j3qq4hch/motion_detect/V4/motion-sensor.png

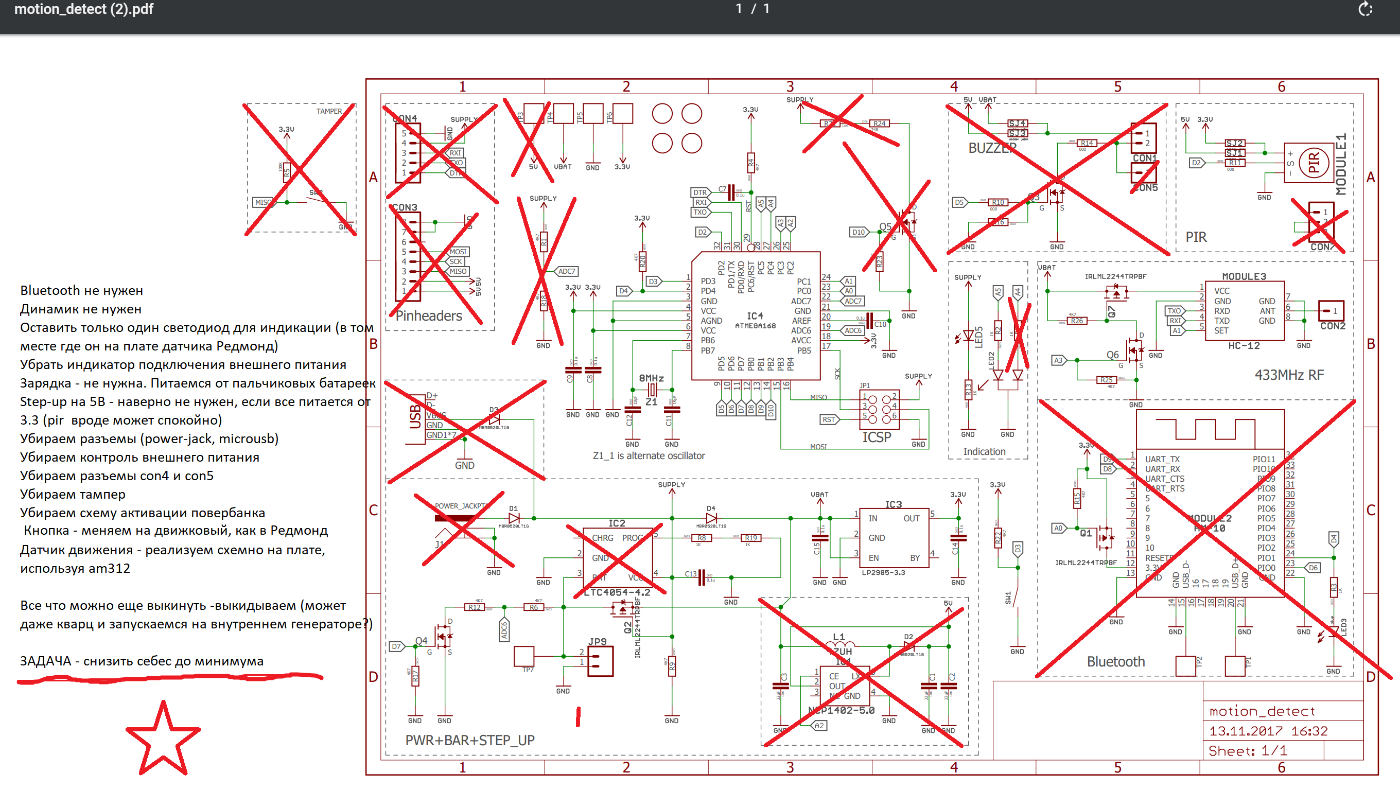
V4/motion-sensor.png
