j3qq4hch/motion_detect/V4/production/BOM.xlsx

Qty | Value | Device | Package | Parts | DIGIKEY# | LINK | MANF | MANF# | Description
1 | RED | LED-3MM | LED-3MM | LED1 |  | https://www.chipdip.ru/product/l-1154id |  |  | Light Emitting Diode
1 |  | M03X2POGO_PINS | 2X3_POGO | JP1 |  | https://www.chipdip.ru/product/pbd-6 |  |  | 2x3 .1 header."
2 | 0.1u | C-0603 | C0603 | C7, C10 |  | https://www.chipdip.ru/product0/9000410929
3 | 0 | R-0603 | R0603 | R8, R9, R10 |  | https://www.chipdip.ru/product0/9000070541
2 | 32pF | C-0603 | C0603 | C11, C12 |  | https://www.chipdip.ru/product/grm1885c1h300j
3 | 1K | R-0603 | R0603 | R13, R20, R27 |  | https://www.chipdip.ru/product0/9000079676
2 | 1M | R-0603 | R0603 | R2, R3 |  | https://www.chipdip.ru/product0/9000079784
7 | 1uF | C-0603 | C0603 | C1, C2, C3, C8, C9, C14, C15 |  | https://www.chipdip.ru/product/grm188r61a105k
1 |  | LP2985-3.3V | SOT23-5L | IC3 | 296-18476-1-ND | https://www.chipdip.ru/product/lp2985-33dbvr | Texas Instruments | LP2985-33DBVR | IC REG LDO 3.3V 0.15A SOT23-5
6 | 4K7 | R-0603 | R0603 | R1, R4, R18, R22, R25, R26 |  | https://www.chipdip.ru/product0/9000079728
1 | 8MHz | CRYSTAL-8MHZHC49UP | HC49UP | Z1 | 535-10212-1-ND | https://www.chipdip.ru/product/8mhz-hc-49sm | Abracon LLC | ABLS-8.000MHZ-B4-T
1 | AM612 | AM612 | AM612 | IC1
1 | ATMEGA168-TQFP32 | ATMEGA168-TQFP32 | TQFP32-08 | IC4 |  | https://www.chipdip.ru/product/atmega168pa-au |  | ATMEGA168
1 | FTDI Basic | ARDUINO_SERIAL_PROGRAMPTH | 1X06 | JP2 |  | https://www.chipdip.ru/product/pls-6
1 | HC12 | HC12 | HC-12 | MODULE3
2 | IRLML2244TRPBF | IRLML2244TRPBF | SOT23B-3 | Q1, Q7 | IRLML2244TRPBFCT-ND | https://www.chipdip.ru/product/irlml2244trpbf | Infineon Technologies | IRLML2244TRPBF | MOSFET P-CH 20V 4.3A SOT23
1 | IRLML2502-SOT23 | IRLML2502-SOT23 | SOT23B-3 | Q6 | IRLML2502PBFTR-ND | https://www.chipdip.ru/product/irlml2502tr | Infineon Technologies | IRLML2502TRPBF | MOSFET N-CH 20V 4.2A SOT-23
1 | PESD5V0S1BB,115 | PESD5V0S1BB,115 | SOD123 | D1 | 1727-3838-2-ND | https://www.chipdip.ru/product/pesd5v0s1ba.115 | Nexperia USA Inc | PESD5V0S1BB,115
1 | TACT_SWITCH-IT-1102S | TACT_SWITCH-IT-1102S | IT-1102S | SW1 |  | https://www.chipdip.ru/product/kls7-ts6604-4.3-180-b-it-1102s
3 | 330K | R-0603 | R0603 | R5, R6, R7 |  | https://www.chipdip.ru/product0/9000079772
