j3qq4hch/motion_detect/(threads)

Thread 1 (2017-06-05):

Большой зазор меду платой и планкой корпуса

Zentelechia, 2017-06-05:
Необходимо на 2мм удлинить сторону с разъемами и светодиодами, т.к, большой зазор до планки корпуса - кнопка не достает до планки, usb-разъем не полностью влезает
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
