j3qq4hch/motion_detect/V4/production/assembly.pdf

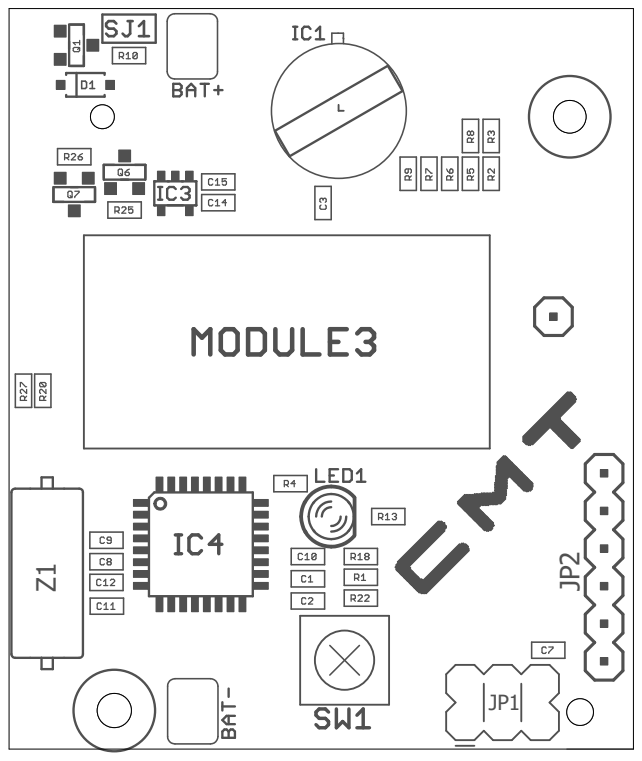
[picture p2: page 1]
