j3qq4hch/motion_detect/V1/production/schematic.pdf

1

2

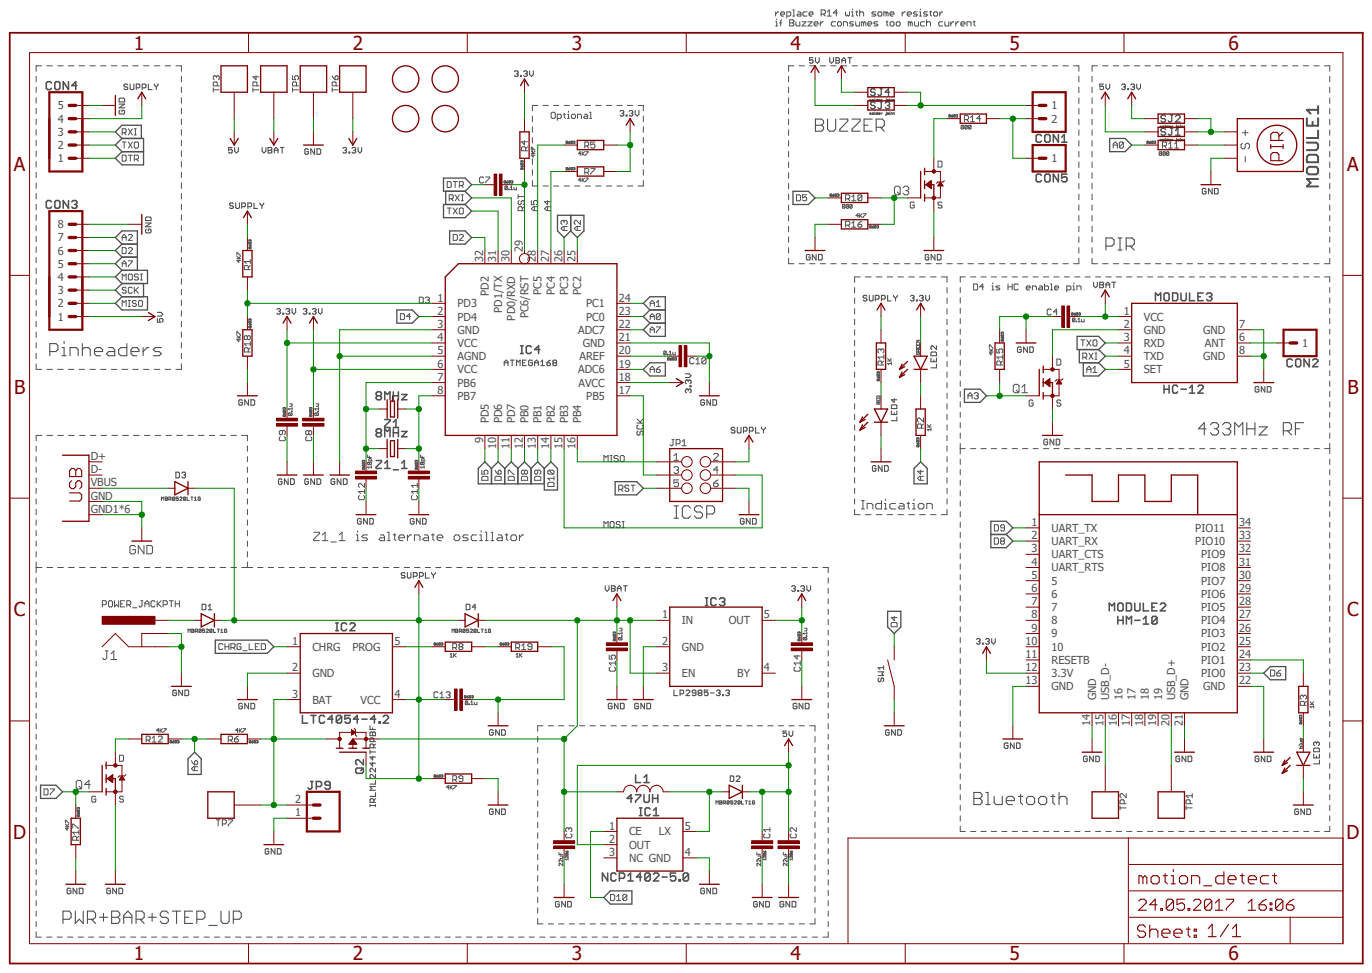
[picture p3: page 1]
OUT; GND; ADC6; ADC7; AGND; AREF; AVCC; VCC; CHRG; BAT; PROG; UART_TX; UART_RX; UART_CTS; UART_RTS; 9 10 10 RESETB 11 3.3V 12 GND 13; GND 14; USB_D- 15; USB_D+ 20 GND 21; 22 PIO0; 23 PIO1; 24 PIO2; 25 PIO3; 26 PIO4; 27 PIO5; 28 PIO6; 29 PIO7; 30 PIO8; 31 PIO9; 32 PIO10; 33 PIO11; RXD; TXD; SET; ANT; 6 GND; D+ D- VBUS GND GND1*6; ABCD

PC2 25 PC3 26 PC4 27 PC5 28 PC6/RST 29 PD0/RXD 30 PD1/TX 31 PD2 32
