j3qq4hch/motion_detect/V3.2/production/bottom.pdf

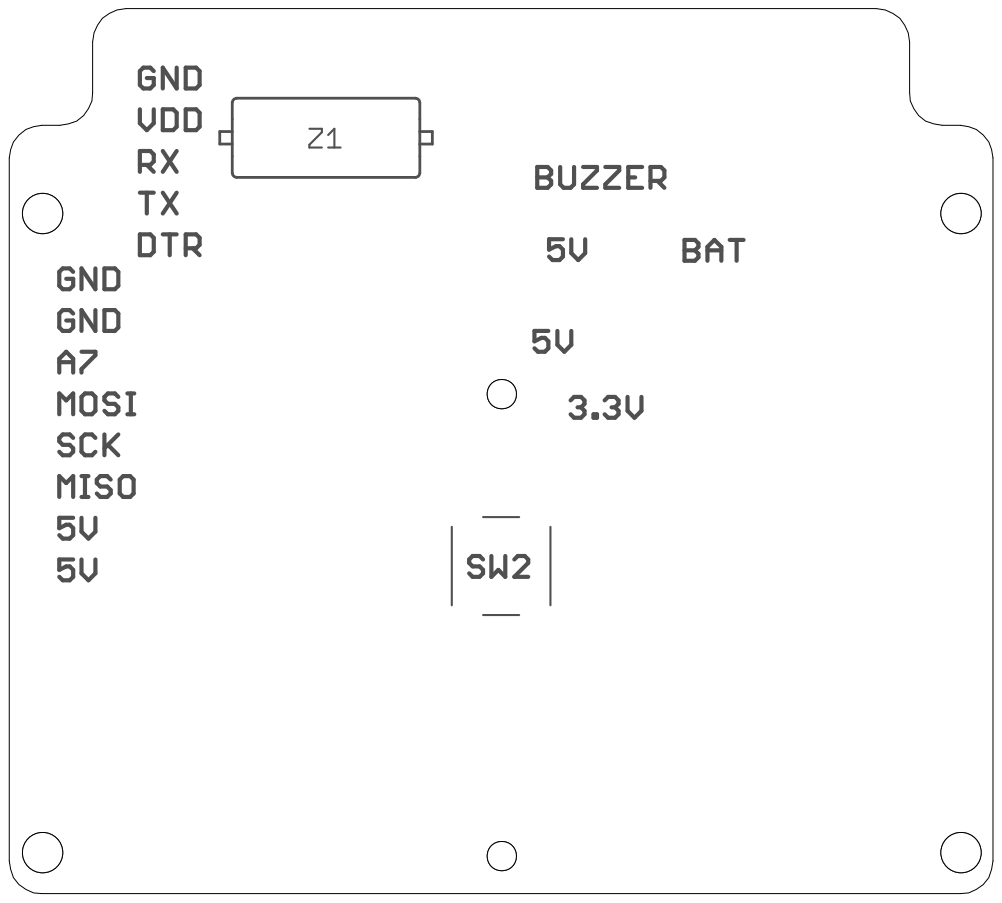
[picture p4: page 1]
