j3qq4hch/motion_detect/V3.2/production/top.pdf

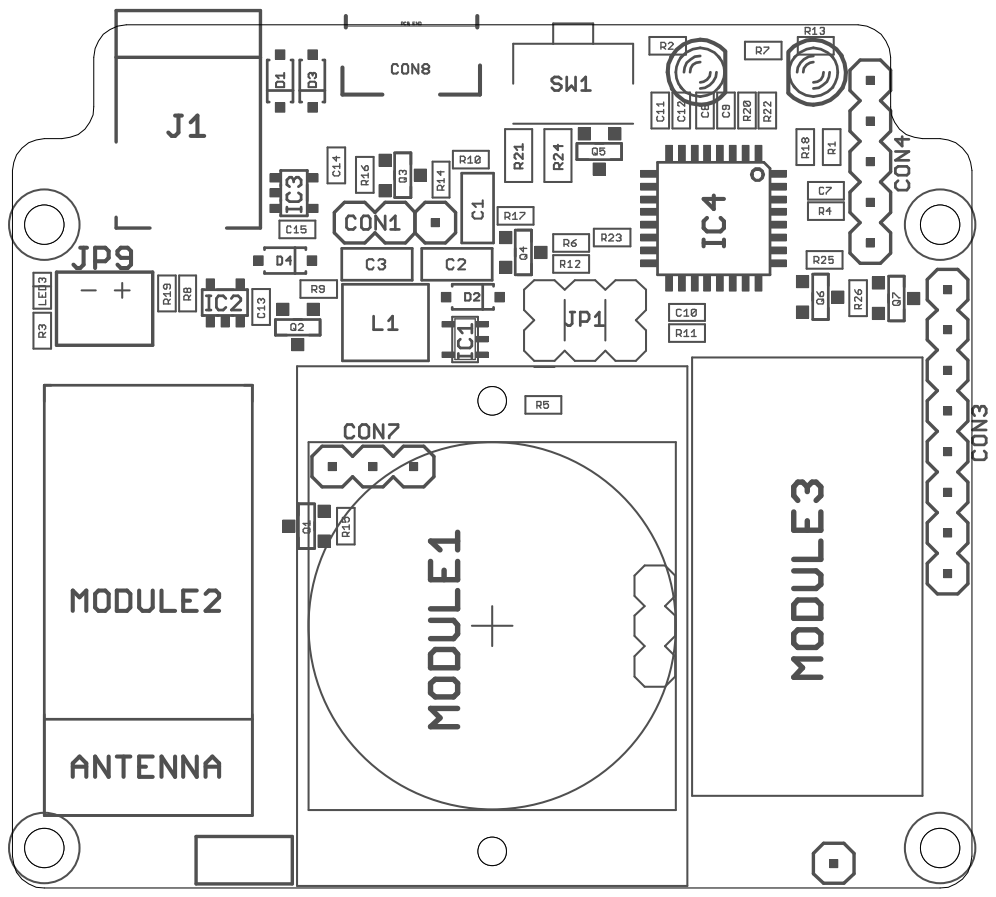
[picture p5: page 1]
