j3qq4hch/motion_detect/V1/production/assy.pdf

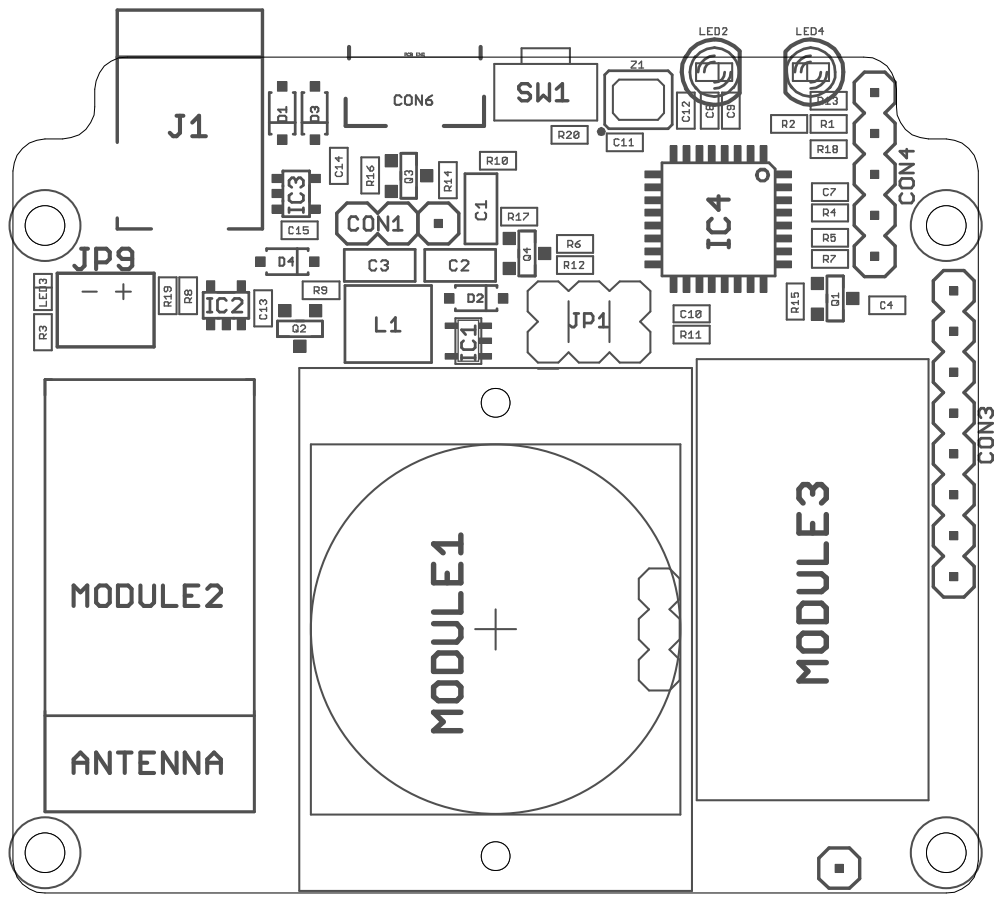
[picture p6: page 1]
