j3qq4hch/motion_detect/V4/motion_detect.brd

## EAGLE design V4/motion_detect.brd (2018-05-14)

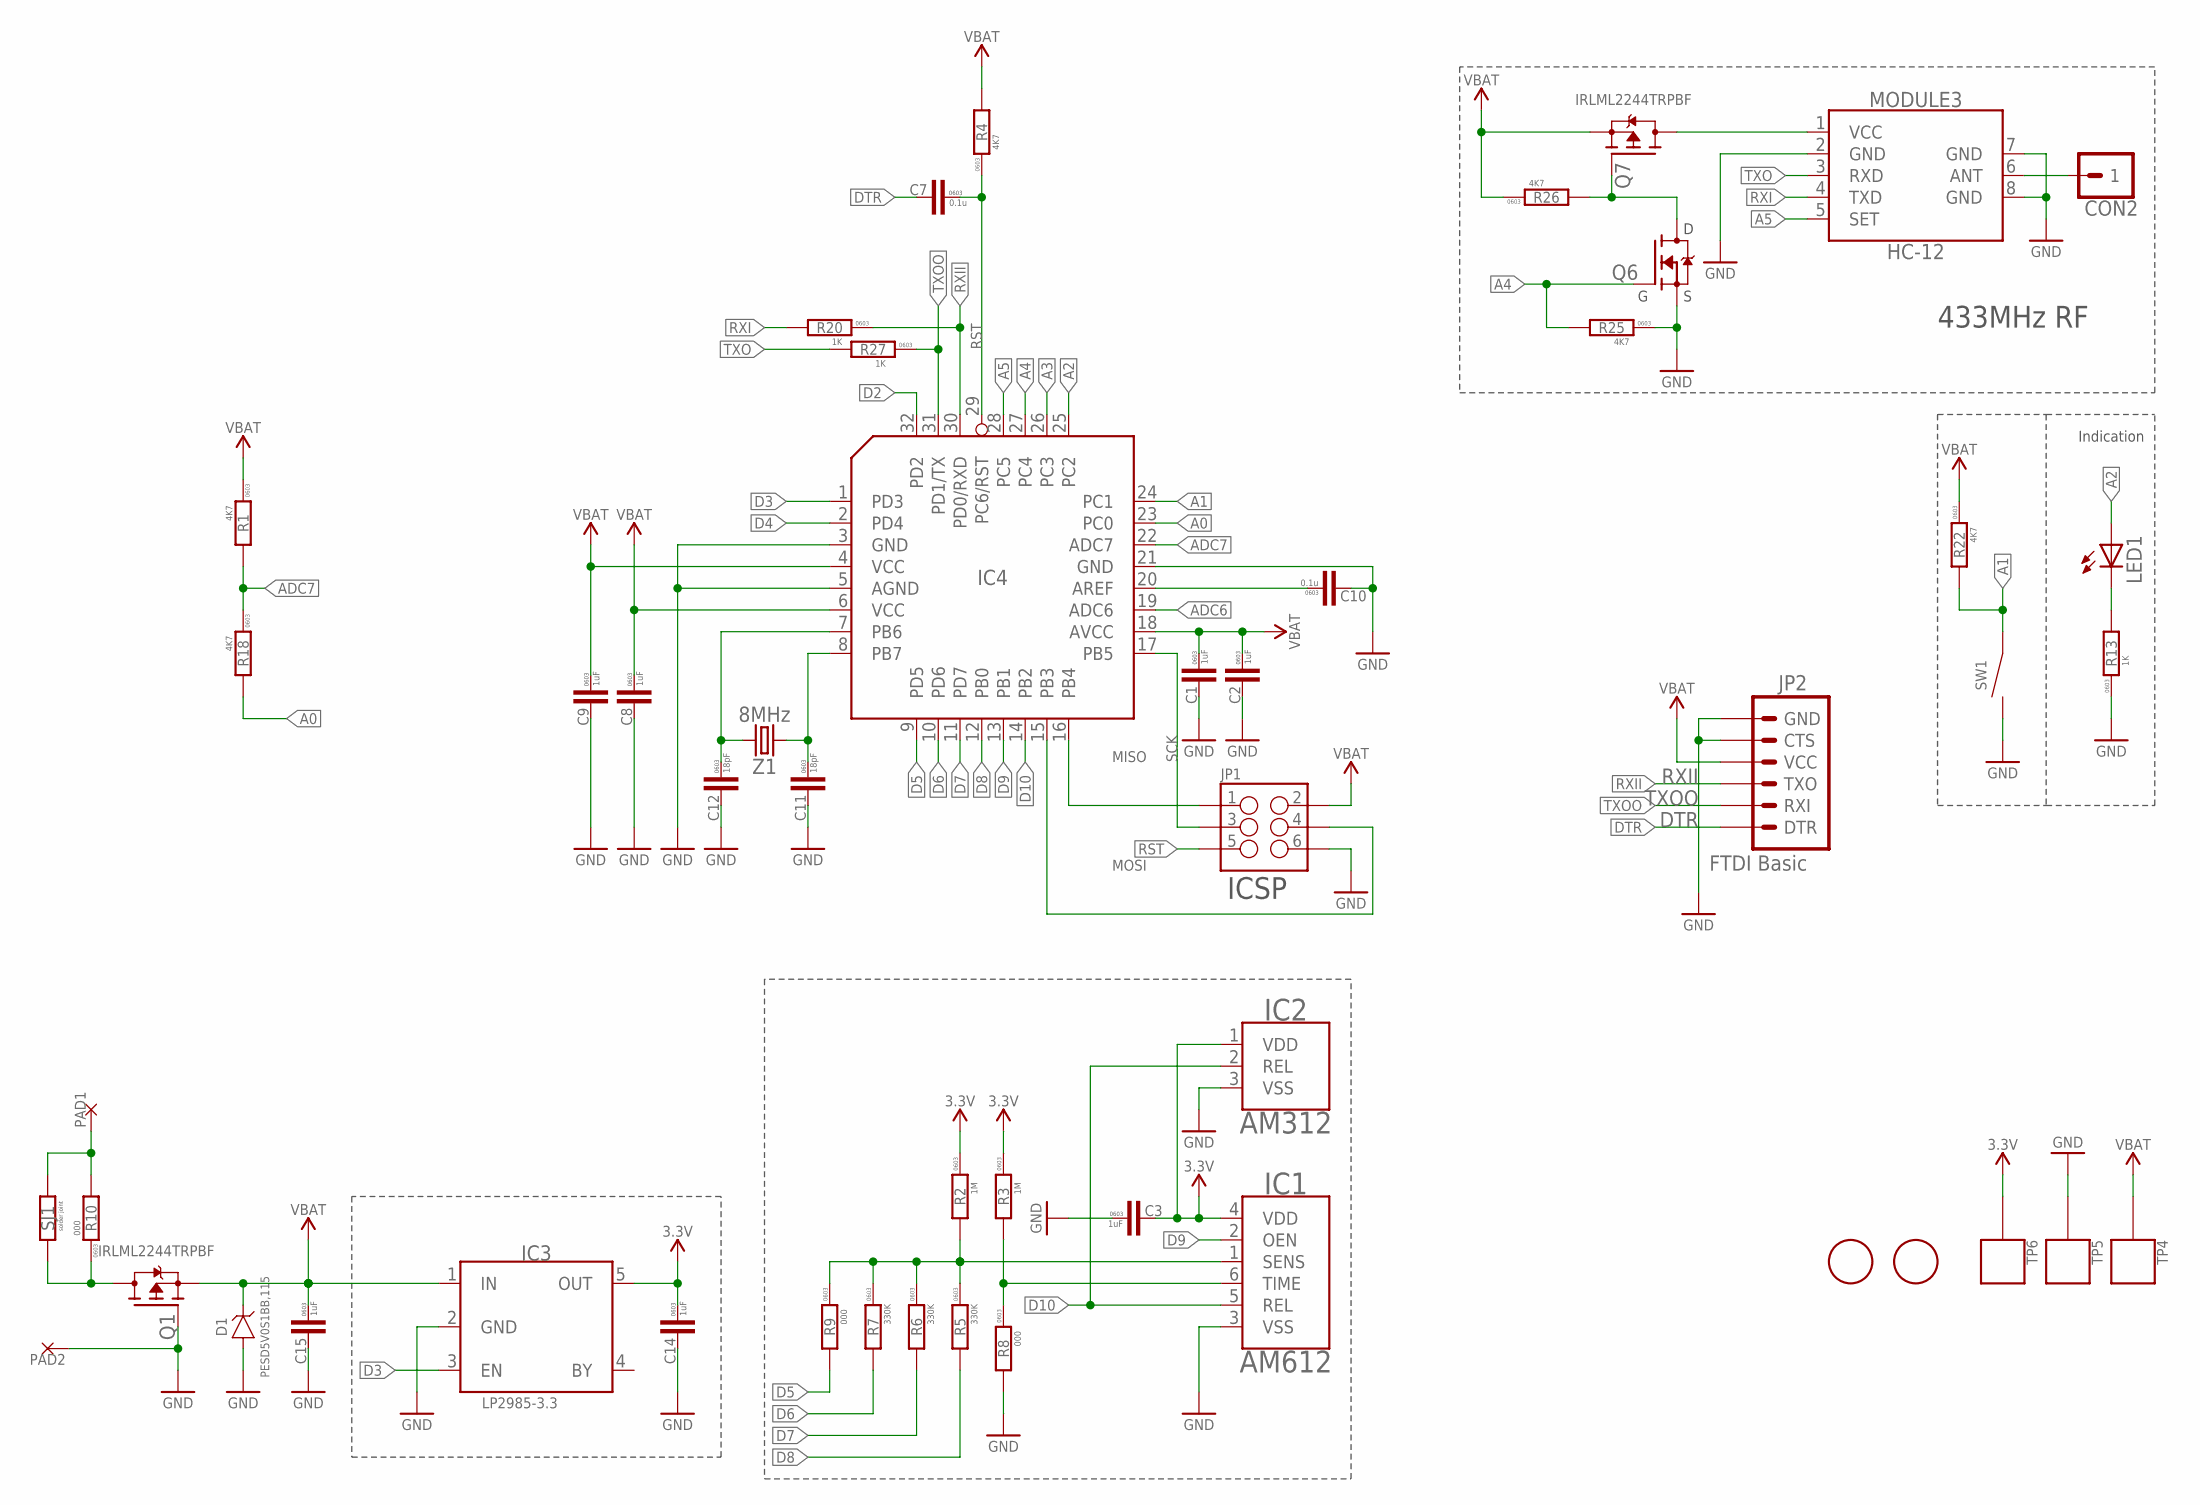
[picture p7: schematic motion_detect.sch]

Parts:
C1, C2, C3, C8, C9, C14, C15: 1uF; C0603
C7, C10: 0.1u; C0603
C11, C12: 18pF; C0603
CON2: PINHEAD_1X01-2.54; 1X01-PTH-2.54
D1: PESD5V0S1BB,115; SOD123
IC1: AM612
IC2: AM312; AM312_SIL
IC3: 3.3; SOT23-5L
IC4: ATMEGA168-TQFP32; TQFP32-08
JP1: M03X2POGO_PINS; 2X3_POGO
JP2: FTDI Basic; 1X06
LED1: LED-3MM
MODULE3: HC12; HC-12
PAD1, PAD2: PAD-4X3; 4X3
Q1, Q7: IRLML2244TRPBF; SOT23B-3
Q6: IRLML2502-SOT23; SOT23B-3
R1, R4, R18, R22, R25, R26: 4K7; R0603
R2, R3: 1M; R0603
R5, R6, R7: 330K; R0603
R8, R9, R10: 000; R0603
R13, R20, R27: 1K; R0603
SJ1: SOLDER_JOINT_2P; SJ_2P
SW1: TACT_SWITCH-IT-1102S; IT-1102S
TP4, TP5, TP6: PAD.05; PAD.05X.05; PARTNO *
U$4, U$6: FIDUCIALMOUNT; FIDUCIA-MOUNT
Z1: 8MHz; HC49UP

Connections:
A0: IC4.23 (PC0), R18.2
A1: IC4.24 (PC1), R22.2, SW1.1, SW1.2 (1)
A2: IC4.25 (PC2), LED1.A
A3: IC4.26 (PC3)
A4: IC4.27 (PC4), Q6.1 (G), R25.2
A5: IC4.28 (PC5), MODULE3.5 (SET)
ADC6: IC4.19 (ADC6)
ADC7: IC4.22 (ADC7), R1.2, R18.1
ANT: CON2.1, MODULE3.6 (ANT)
D2: IC4.32 (PD2)
D3: IC3.3 (EN), IC4.1 (PD3)
D4: IC4.2 (PD4)
D5: IC4.9 (PD5), R9.2
D6: IC4.10 (PD6), R7.2
D7: IC4.11 (PD7), R6.2
D8: IC4.12 (PB0), R5.2
D9: IC1.2 (OEN), IC4.13 (PB1)
D10: IC1.5 (REL), IC2.2 (REL), IC4.14 (PB2)
DTR: C7.2, JP2.1 (DTR)
GND: C1.2, C2.2, C3.1, C8.2, C9.2, C10.2, C11.2, C12.2, C14.2, C15.2, D1.A, IC1.3 (VSS), IC2.3 (VSS), IC3.2 (GND), IC4.3 (GND), IC4.5 (AGND), IC4.21 (GND), JP1.P$6 (6), JP2.5 (CTS), JP2.6 (GND), MODULE3.2 (GND), MODULE3.7 (GND), MODULE3.8 (GND), PAD2.P$1, Q1.1 (G), Q6.2 (S), R8.2, R13.1, R25.1, SW1.3 (2), SW1.4 (2), TP5.P$1
MISO: IC4.16 (PB4), JP1.P$1 (1)
MOSI: IC4.15 (PB3), JP1.P$4 (4)
unnamed: PAD1.P$1, R10.2, SJ1.2
unnamed: IC1.6 (TIME), R3.2, R8.1
unnamed: C10.1, IC4.20 (AREF)
unnamed: IC1.1 (SENS), R2.2, R5.1, R6.1, R7.1, R9.1
unnamed: C12.1, IC4.7 (PB6), Z1.2
unnamed: Q1.3 (D), R10.1, SJ1.1
unnamed: C11.1, IC4.8 (PB7), Z1.1
unnamed: LED1.K (C), R13.2
unnamed: MODULE3.1 (VCC), Q7.3 (D)
unnamed: Q6.3 (D), Q7.1 (G), R26.2
RST: C7.1, IC4.29 (PC6/RST), JP1.P$5 (5), R4.1
RXI: MODULE3.4 (TXD), R20.2
RXII: IC4.30 (PD0/RXD), JP2.3 (TXO), R20.1
SCK: IC4.17 (PB5), JP1.P$3 (3)
TXO: MODULE3.3 (RXD), R27.2
TXOO: IC4.31 (PD1/TX), JP2.2 (RXI), R27.1
VBAT: C1.1, C2.1, C8.1, C9.1, C15.1, D1.C, IC3.1 (IN), IC4.4 (VCC), IC4.6 (VCC), IC4.18 (AVCC), JP1.P$2 (2), JP2.4 (VCC), Q1.2 (S), Q7.2 (S), R1.1, R4.2, R22.1, R26.1, TP4.P$1
VDD_3V3: C3.2, C14.1, IC1.4 (VDD), IC2.1 (VDD), IC3.5 (OUT), R2.1, R3.1, TP6.P$1

Notes on the sheet:
433MHz RF
Indication
ICSP

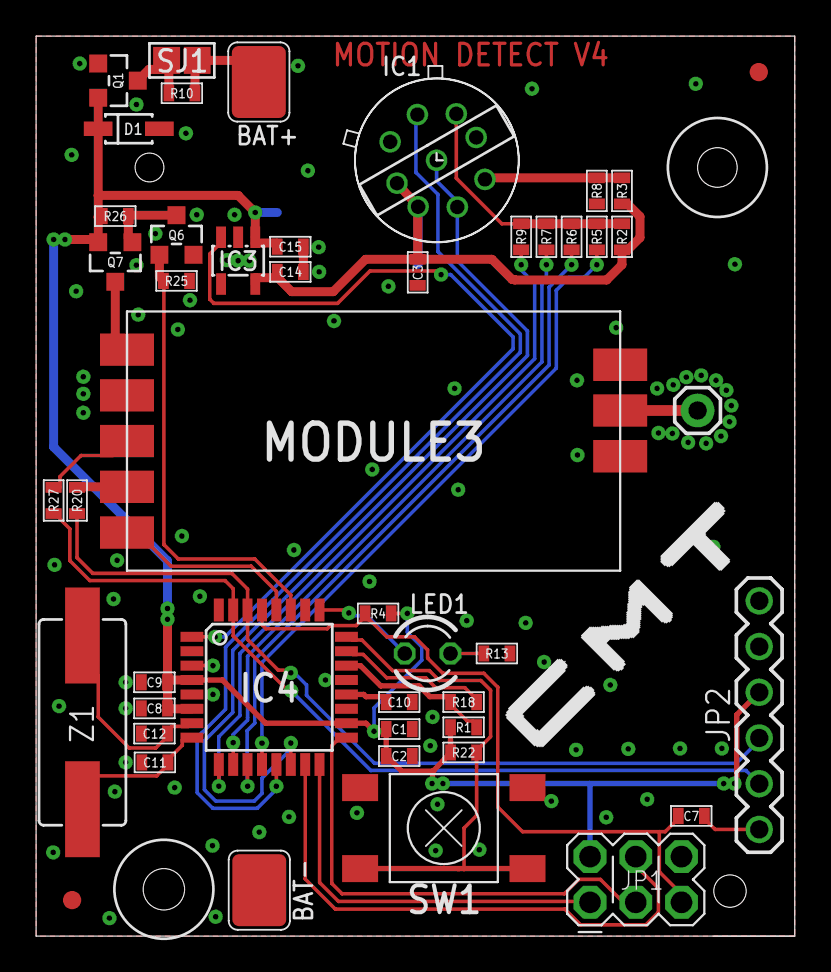
[picture p8: board V4/motion_detect.brd from above]

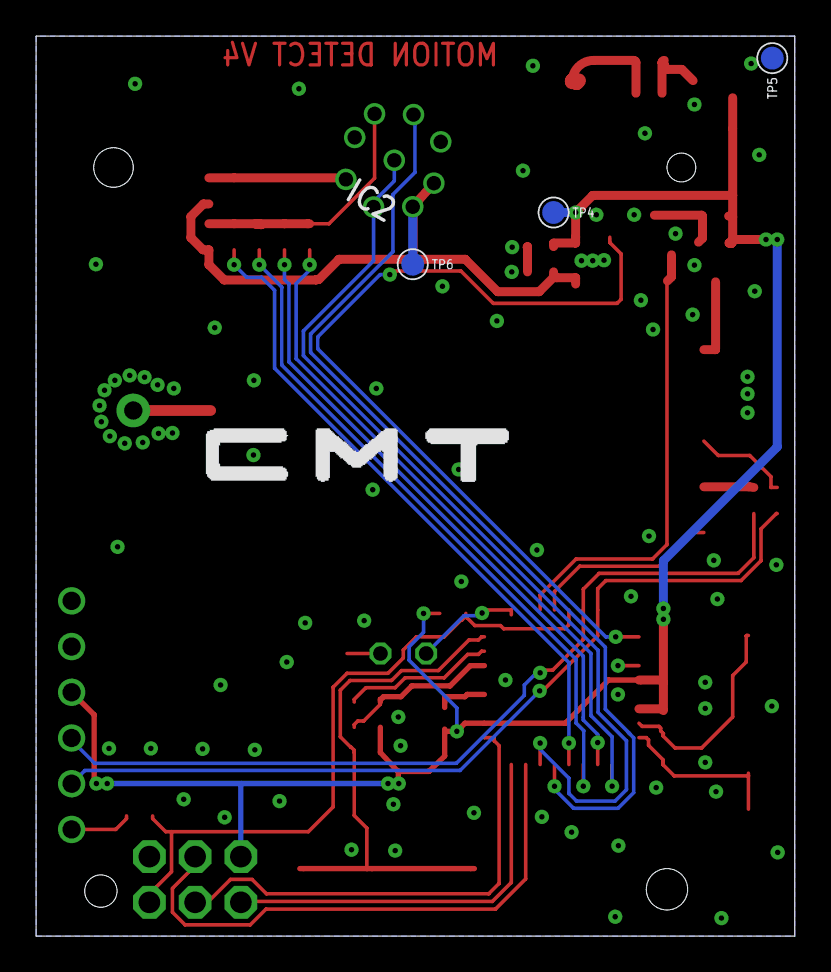
[picture p9: board V4/motion_detect.brd from below]

Board: 4 copper layers, 42.1 x 50.0 mm, 54 parts (6 on the bottom side), 36 nets.

Other parts of the board:
U$1, U$3: SMT_LOGO
U$2: REDMOND_BOARD
