j3qq4hch/motion_detect/V3.2/motion_detect.brd

## EAGLE design V3.2/motion_detect.brd (2018-05-07, an earlier design)

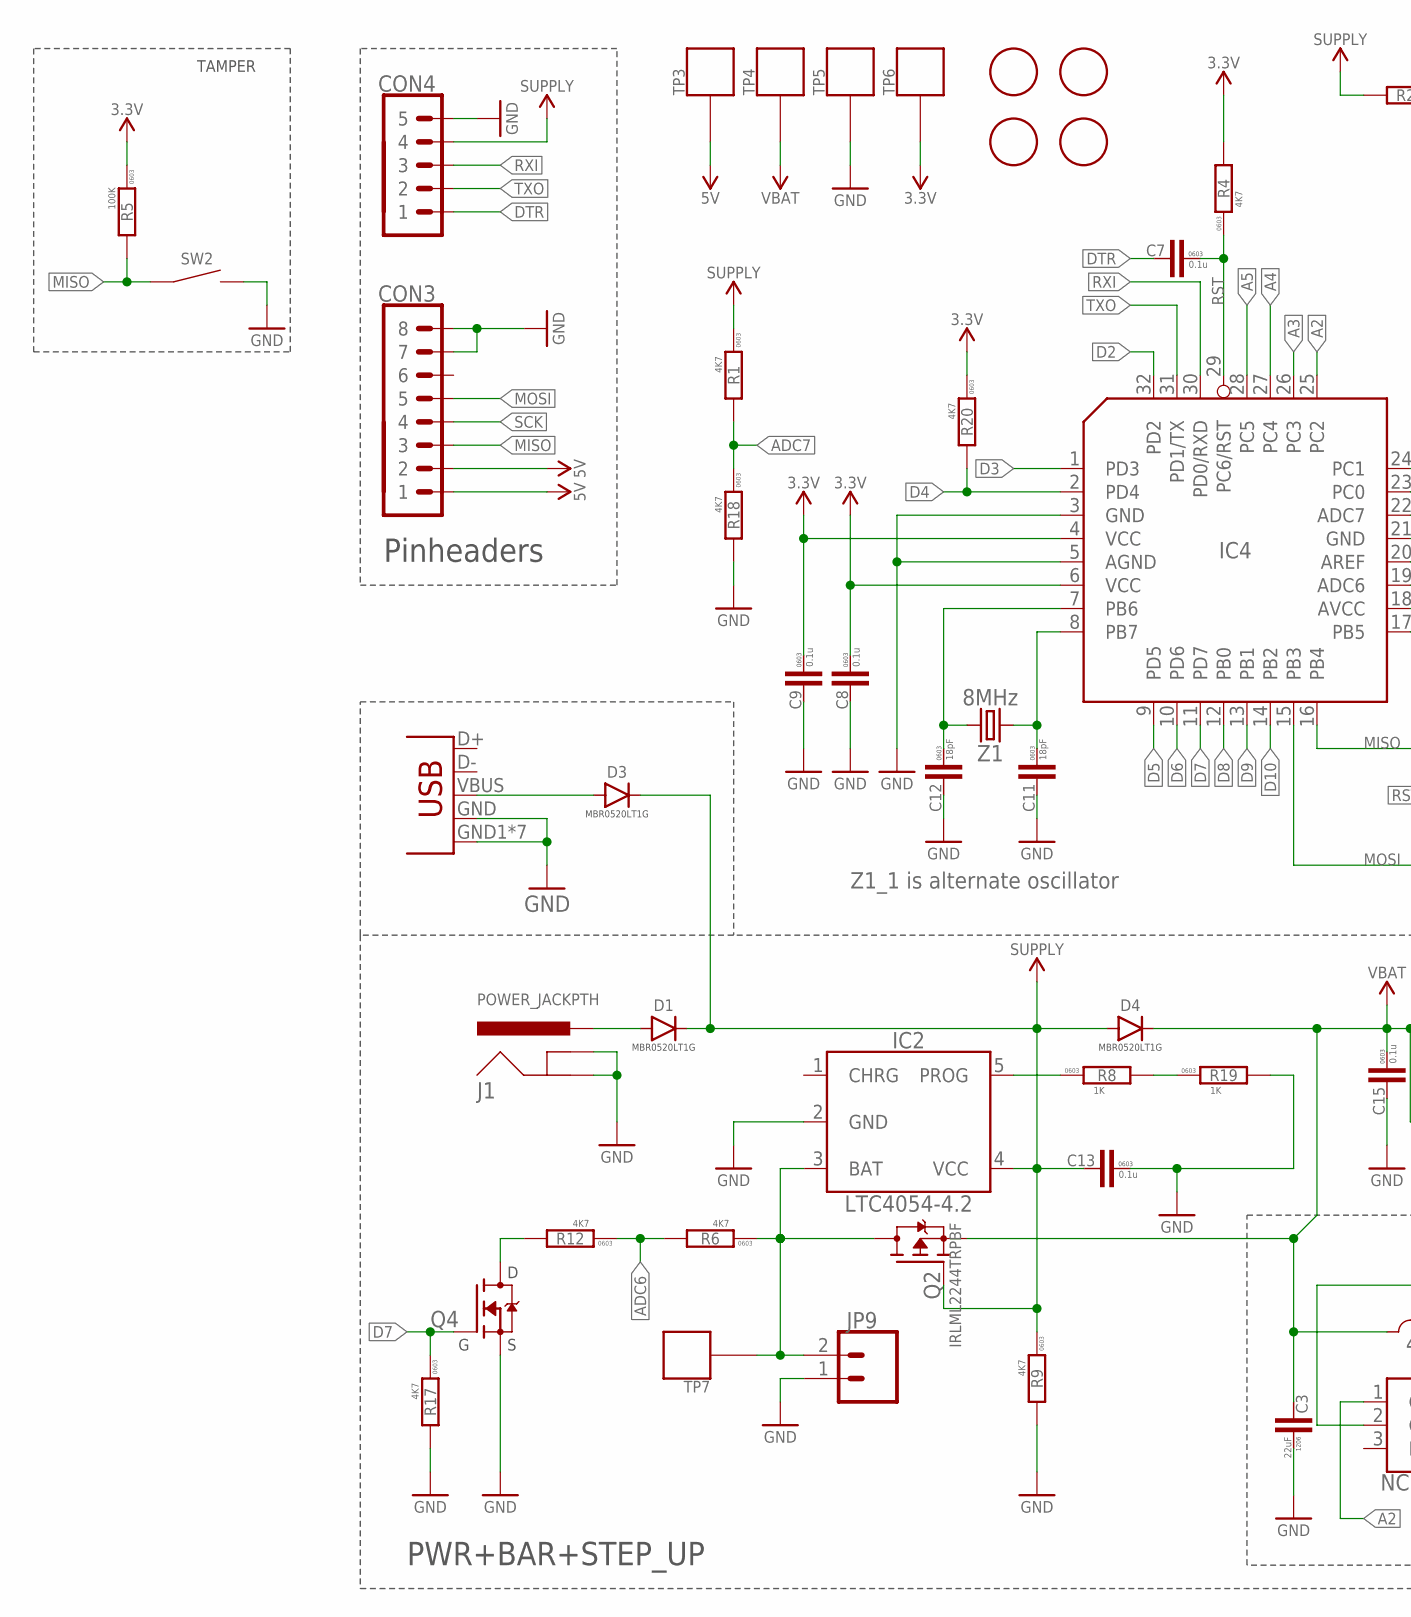
[picture p10: schematic motion_detect.sch, part in row 1, column 1]

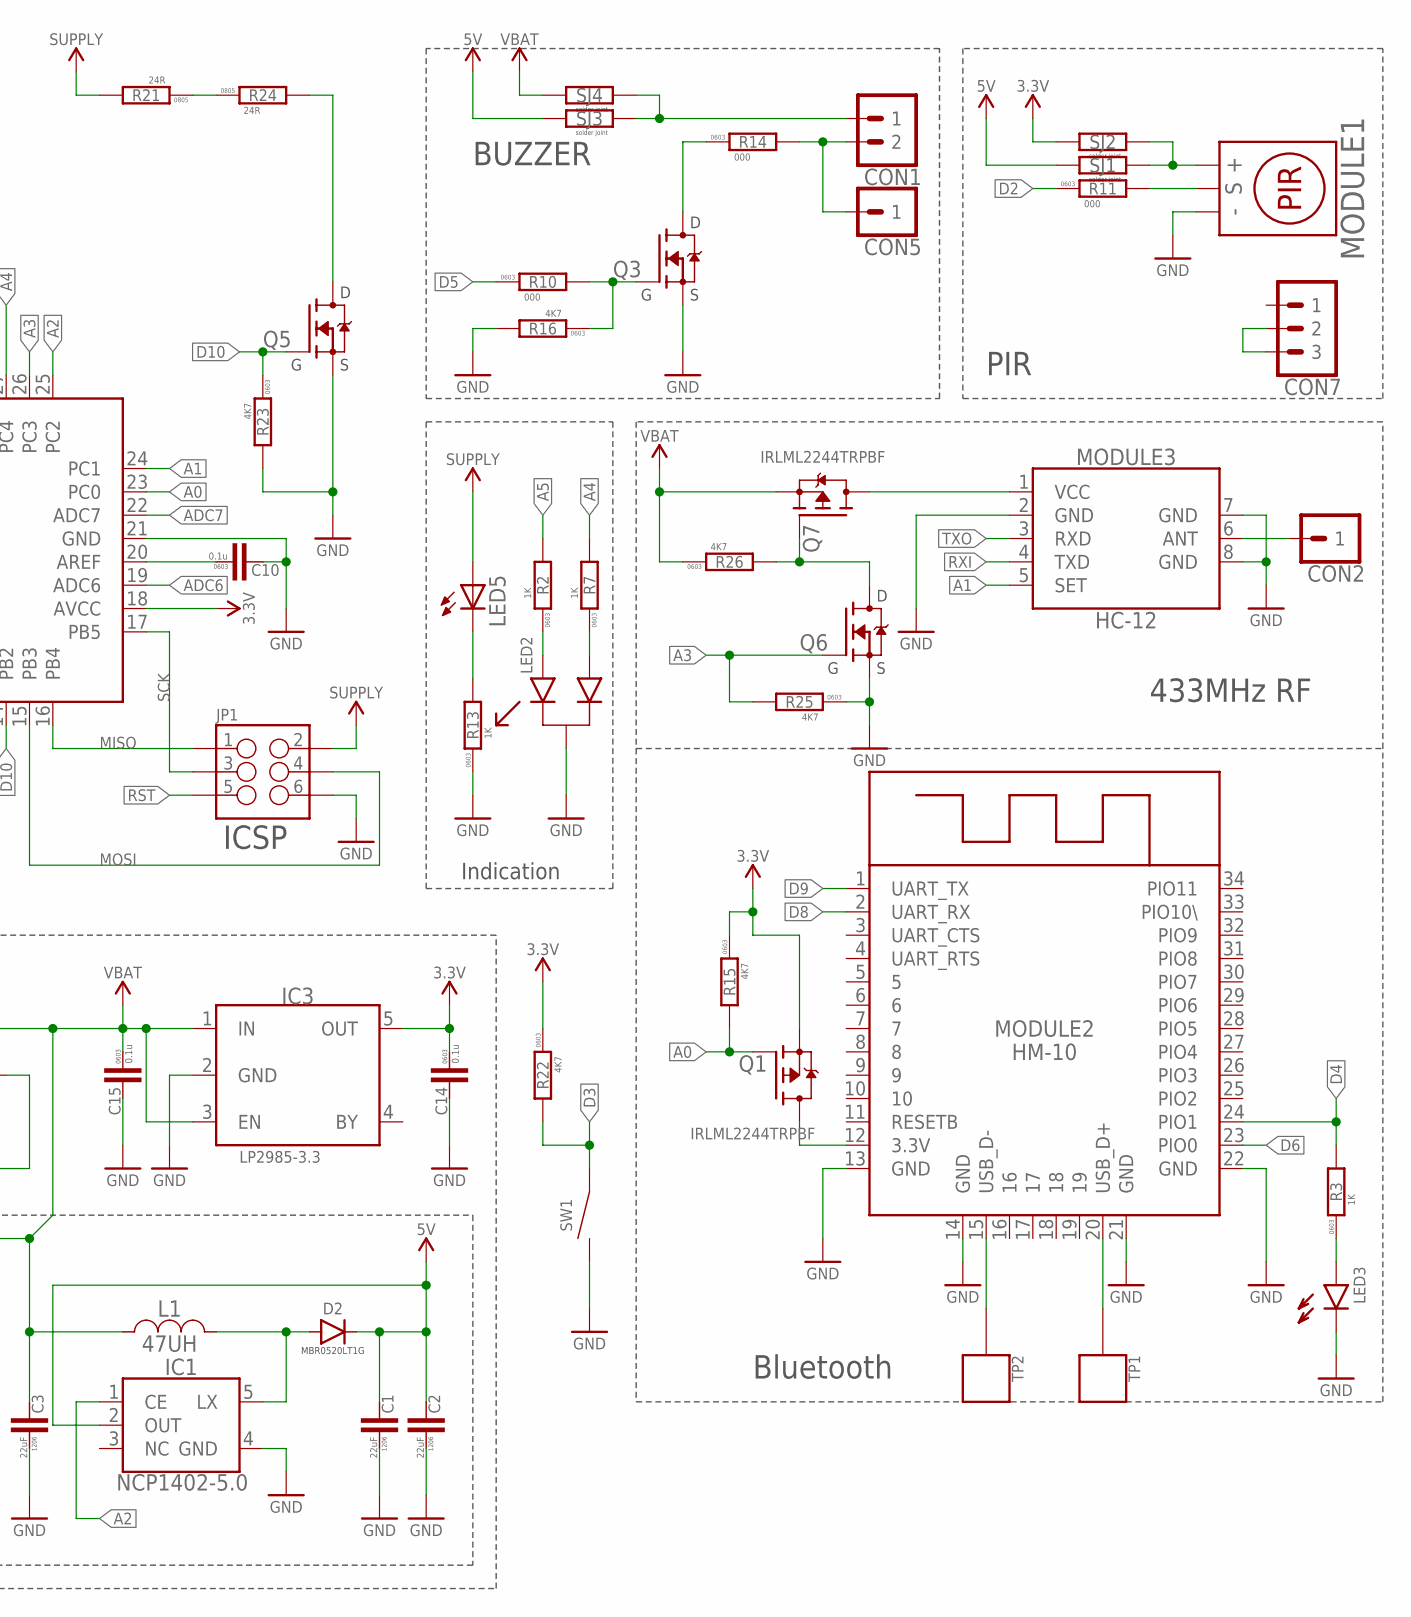
[picture p11: schematic motion_detect.sch, part in row 1, column 2]

Parts:
C1, C2, C3: 22uF; C1206
C7, C8, C9, C10, C13, C14, C15: 0.1u; C0603
C11, C12: 18pF; C0603
CON1: PINHEAD_1X02-2.54; 1X02-PTH-2.54
CON2, CON5: PINHEAD_1X01-2.54; 1X01-PTH-2.54
CON3: PINHEAD_1X08-2.54; 1X08-PTH-2.54
CON4: PINHEAD_1X05-2.54; 1X05-PTH-2.54
CON7: PINHEAD_1X03-2.54; 1X03-PTH-2.54
CON8: USB-1; MICRO_USB_WITH_PEGS
D1, D2, D3, D4: MBR0520L-SOD123; SOD123
IC1: 5.0; SOT23-5
IC2: LTC4054; SOT23-5L
IC3: 3.3; SOT23-5L
IC4: ATMEGA168-TQFP32; TQFP32-08
J1: POWER_JACKPTH; POWER_JACK_PTH
JP1: M03X2POGO_PINS; 2X3_POGO
JP9: M02-B2B-PH-K-S; JST-2-PTH
L1: 47UH; SDR0403
LED2: BL-L315EGW; BL-L315
LED3: LED-0603; LED0603
LED5: LED-3MM
MODULE1: MOTION-PIR-DYP-ME003
MODULE2: HM-10
MODULE3: HC12; HC-12
Q1, Q2, Q7: IRLML2244TRPBF; SOT23B-3
Q3, Q4, Q5, Q6: IRLML2502-SOT23; SOT23B-3
R1, R4, R6, R9, R12, R15, R16, R17, R18, R20, R22, R23, R25, R26: 4K7; R0603
R2, R3, R7, R8, R13, R19: 1K; R0603
R5: 100K; R0603
R10, R11, R14: 000; R0603
R21, R24: 24R; R0805
SJ1, SJ2, SJ3, SJ4: SOLDER_JOINT; RES_0
SW1: TACT_SWITCH-TC-206; TC-0206
SW2: TACT_SWITCH; FSM8JH
TP1, TP2, TP3, TP4, TP5, TP6, TP7: PAD.05; PAD.05X.05; PARTNO *
U$3, U$4, U$5, U$6: FIDUCIALMOUNT; FIDUCIA-MOUNT
Z1: 8MHz; HC49UP

Connections:
A0: IC4.23 (PC0), Q1.1 (G), R15.2
A1: IC4.24 (PC1), MODULE3.5 (SET)
A2: IC1.1 (CE), IC4.25 (PC2)
A3: IC4.26 (PC3), Q6.1 (G), R25.2
A4: IC4.27 (PC4), R7.2
A5: IC4.28 (PC5), R2.2
ADC6: IC4.19 (ADC6), R6.2, R12.1
ADC7: IC4.22 (ADC7), R1.2, R18.1
ANT: CON2.1, MODULE3.6 (ANT)
BAT+: IC2.3 (BAT), JP9.2, Q2.3 (D), R6.1, TP7.P$1
D2: IC4.32 (PD2), R11.1
D3: IC4.1 (PD3), R22.2, SW1.1
D4: IC4.2 (PD4), MODULE2.24 (PIO1), R3.2, R20.2
D5: IC4.9 (PD5), R10.1
D6: IC4.10 (PD6), MODULE2.23 (PIO0)
D7: IC4.11 (PD7), Q4.1 (G), R17.1
D8: IC4.12 (PB0), MODULE2.2 (UART_RX)
D9: IC4.13 (PB1), MODULE2.1 (UART_TX)
D10: IC4.14 (PB2), Q5.1 (G), R23.1
DTR: C7.2, CON4.1
GND: C1.P$1 (1), C2.P$1 (1), C3.P$1 (1), C8.2, C9.2, C10.2, C11.2, C12.2, C13.1, C14.2, C15.2, CON3.7, CON3.8, CON4.5, CON8.GND, CON8.GND1 (SHIELD), CON8.GND2 (SHIELD), CON8.GND3 (SHIELD), CON8.GND4 (SHIELD), CON8.ID (SHIELD), CON8.P$1 (SHIELD), CON8.P$2 (SHIELD), IC1.4 (GND), IC2.2 (GND), IC3.2 (GND), IC4.3 (GND), IC4.5 (AGND), IC4.21 (GND), J1.GND, J1.GNDBREAK, JP1.P$6 (6), JP9.1, LED2.C, LED3.C, MODULE1.1 (GND), MODULE2.13 (GND), MODULE2.14 (GND), MODULE2.21 (GND), MODULE2.22 (GND), MODULE3.2 (GND), MODULE3.7 (GND), MODULE3.8 (GND), Q3.2 (S), Q4.2 (S), Q5.2 (S), Q6.2 (S), R9.2, R13.1, R16.2, R17.2, R18.2, R19.2, R23.2, R25.1, SW1.2, SW2.3 (2), SW2.4 (2), TP5.P$1
MISO: CON3.3, IC4.16 (PB4), JP1.P$1 (1), R5.2, SW2.1, SW2.2 (1)
MOSI: CON3.5, IC4.15 (PB3), JP1.P$4 (4)
unnamed: MODULE2.12 (3.3V), Q1.3 (D)
unnamed: LED2.AG (A), R2.1
unnamed: LED3.A, R3.1
unnamed: C10.1, IC4.20 (AREF)
unnamed: D2.A, IC1.5 (LX), L1.P$2 (2)
unnamed: C12.1, IC4.7 (PB6), Z1.2
unnamed: R8.2, R19.1
unnamed: C11.1, IC4.8 (PB7), Z1.1
unnamed: IC2.5 (PROG), R8.1
unnamed: CON8.VBUS, D3.A
unnamed: MODULE1.2 (OUT), R11.2
unnamed: LED5.K (C), R13.2
unnamed: D1.A, J1.PWR
unnamed: CON7.2, CON7.3
unnamed: Q3.1 (G), R10.2, R16.1
unnamed: MODULE2.15 (USB_D-), TP2.P$1
unnamed: MODULE1.3 (VCC), SJ1.2, SJ2.2
unnamed: MODULE2.20 (USB_D+), TP1.P$1
unnamed: R21.1, R24.1
unnamed: Q3.3 (D), R14.1
unnamed: Q4.3 (D), R12.2
unnamed: CON1.1, SJ3.2, SJ4.2
unnamed: CON1.2, CON5.1, R14.2
unnamed: MODULE3.1 (VCC), Q7.3 (D)
unnamed: Q5.3 (D), R24.2
unnamed: LED2.AR (A1), R7.1
unnamed: Q6.3 (D), Q7.1 (G), R26.2
RST: C7.1, IC4.29 (PC6/RST), JP1.P$5 (5), R4.1
RXI: CON4.3, IC4.30 (PD0/RXD), MODULE3.4 (TXD)
SCK: CON3.4, IC4.17 (PB5), JP1.P$3 (3)
SUP: C13.2, CON4.4, D1.C, D3.C, D4.A, IC2.4 (VCC), JP1.P$2 (2), LED5.A, Q2.1 (G), R1.1, R9.1, R21.2
TXO: CON4.2, IC4.31 (PD1/TX), MODULE3.3 (RXD)
VBAT: C3.P$2 (2), C15.1, D4.C, IC3.1 (IN), IC3.3 (EN), L1.P$1 (1), Q2.2 (S), Q7.2 (S), R26.1, SJ4.1, TP4.P$1
VDD_3V3: C8.1, C9.1, C14.1, IC3.5 (OUT), IC4.4 (VCC), IC4.6 (VCC), IC4.18 (AVCC), Q1.2 (S), R4.2, R5.1, R15.1, R20.1, R22.1, SJ2.1, TP6.P$1
VDD_5V: C1.P$2 (2), C2.P$2 (2), CON3.1, CON3.2, D2.C, IC1.2 (OUT), SJ1.1, SJ3.1, TP3.P$1

Notes on the sheet:
BUZZER
433MHz RF
Bluetooth
PWR+BAR+STEP_UP
Pinheaders
Indication
ICSP
PIR
Z1_1 is alternate oscillator
TAMPER

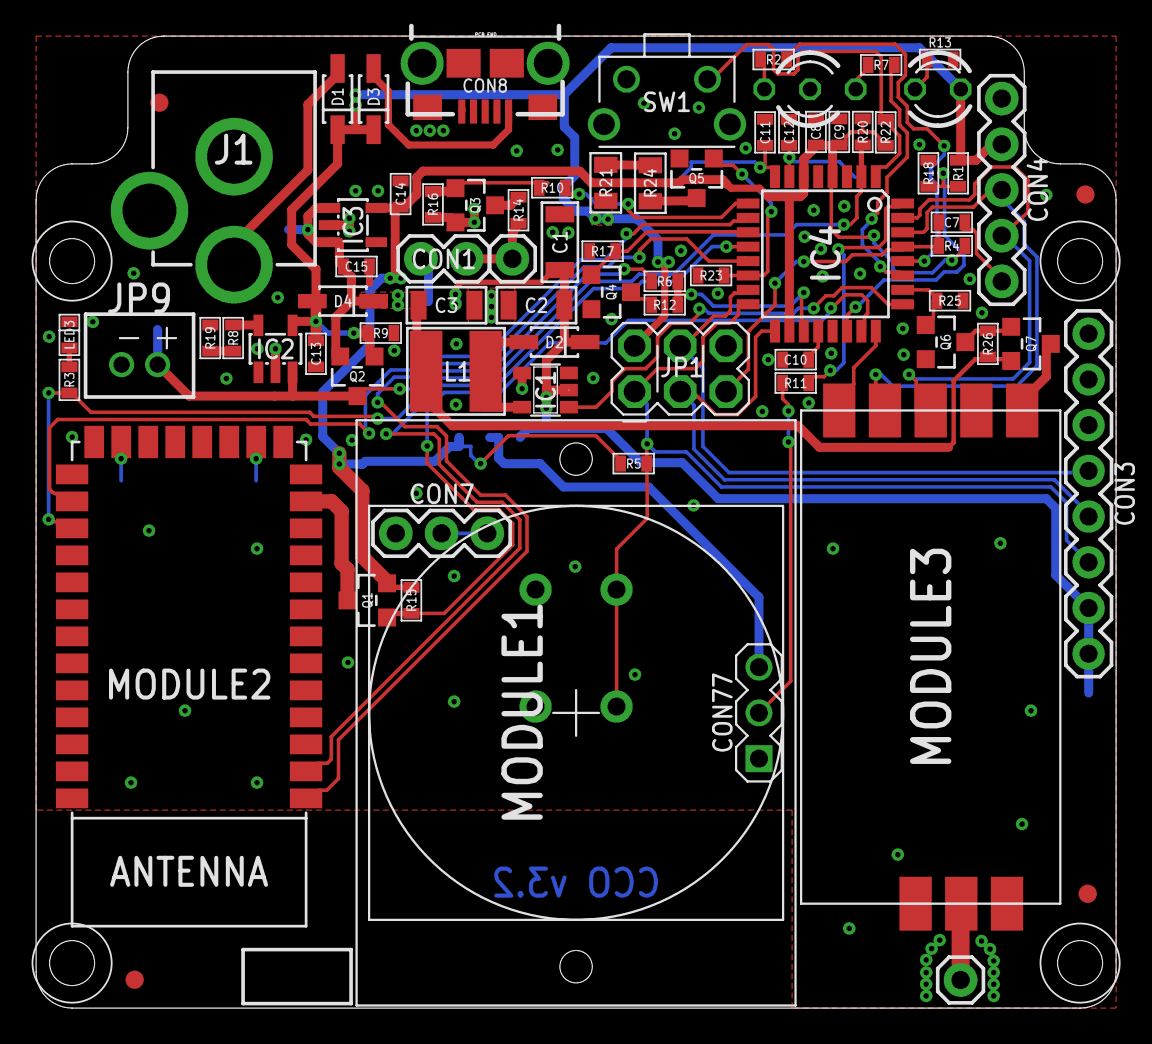
[picture p12: board V3.2/motion_detect.brd from above]

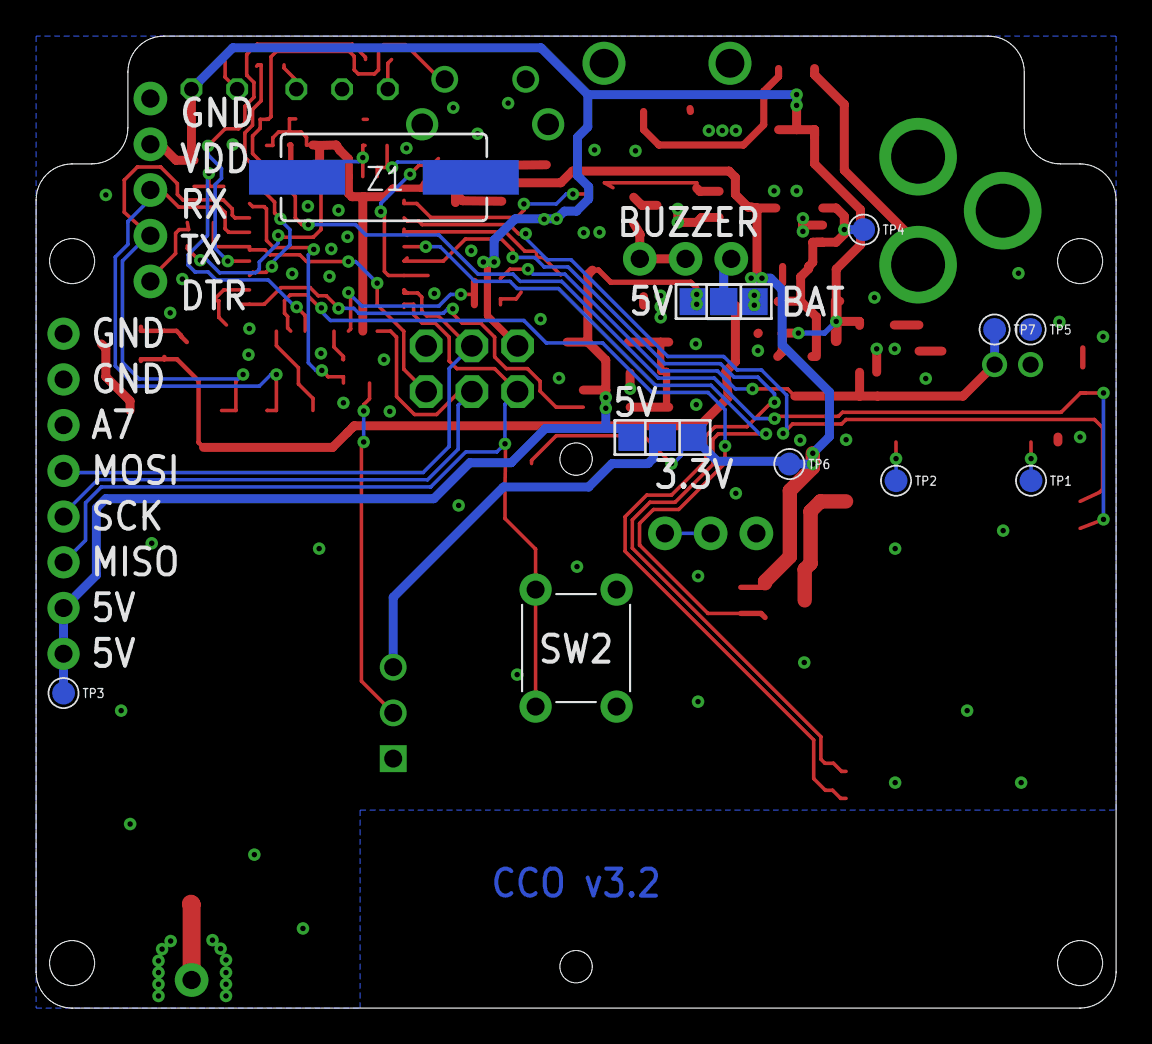
[picture p13: board V3.2/motion_detect.brd from below]

Board: 2 copper layers, 60.0 x 54.0 mm, 89 parts (13 on the bottom side), 58 nets.

Other parts of the board:
U$1: BOARD_OUTLINE
