j3qq4hch/motion_detect/(commit log)

2017-05-26 initial import
    [BOM.ods, motion_detect.brd, motion_detect.sch]
2017-05-30 some minor BOM fixes
    [BOM.ods, motion_detect.brd, motion_detect.sch]
2017-07-06 new version
    [BOM.ods, motion_detect.brd, motion_detect.sch]
2017-07-18 -assembly drawings added
    [motion_detect.brd]
2017-08-16 Fixed silkscreeen
    [motion_detect.brd]
2018-05-07 impport of everything
    [BOM.ods, motion_detect.brd, motion_detect.sch]
2018-05-07 some more stuff import
    [motion_detect.brd]
2018-05-08 vias update
    [motion_detect.brd]
2018-05-14 Production files added
    [BOM.xlsx, motion_detect.brd, motion_detect.sch]
